Apple-spain/AppleII-VGA/AppleVGA/AppleVGA_BOM.xlsx

referencia | Descripcion | qty | P_Ali
PCB | Apple2vga | 1 | https://github.com/markadev/AppleII-VGA/
C1 – C58 | 0.1 uF, MLCC, 5 mm Pitch | 5 | https://es.aliexpress.com/item/1005001715033995.html?mp=1
C2 | Condensador 330nF THT radial 5.00mm entre pines | 1 | https://es.aliexpress.com/item/1005001715033995.html?mp=1
D1 | Diodo axial THT DO-41 schottky | 1 | https://es.aliexpress.com/item/1005004443278541.html?curPageLogUid=mMnkBYfFPmfH
J2 | Conector PinHeader 1x08 paso 2.54mm Vertical | 1 | https://es.aliexpress.com/item/4000857385112.html?pdp_pi=-1%252
J3 | Conector DSUB-15-HD VGA Female Horizontal (90º) | 1 | https://es.aliexpress.com/item/1005004701670869.html?curPageLogUid=ZuGPMabfmleB
R1-R3 | Resistencia 330R Axial THT 1/4W | 3 | https://es.aliexpress.com/item/4000695402017.html?spm=a2g0s.9042311.0.0.274263c0KP7QF1
R4, R7, R10 | Resistencia 500R Axial THT 1/4W (510R) | 3 | https://es.aliexpress.com/item/4000695402017.html?spm=a2g0s.9042311.0.0.274263c0KP7QF1
R5, R8, R11 | Resistencia 1K Axial THT 1/4W | 3 | https://es.aliexpress.com/item/4000695402017.html?spm=a2g0s.9042311.0.0.274263c0KP7QF1
R6, R9, R12 | Resistencia 2K Axial THT 1/4W | 3 | https://es.aliexpress.com/item/4000695402017.html?spm=a2g0s.9042311.0.0.274263c0KP7QF1
R13, R14 | Resistencia 47R Axial THT 1/4W | 2 | https://es.aliexpress.com/item/4000695402017.html?spm=a2g0s.9042311.0.0.274263c0KP7QF1
R15-R17 | Resistencia 10K Axial THT 1/4W | 3 | https://es.aliexpress.com/item/4000695402017.html?spm=a2g0s.9042311.0.0.274263c0KP7QF1
SW1 | Botón pulsador DPST (on)-off paso 6mm | 1 | https://es.aliexpress.com/item/4000695402017.html?spm=a2g0s.9042311.0.0.274263c0KP7QF1
U1-U3 | 74LVC245 DIP-20 | 3 | https://es.aliexpress.com/item/1005003499320188.html
U4 | 74LS07 DIP-14 | 1 | https://es.aliexpress.com/item/1005003087978058.html?mp=1
U5 | Regulador de voltaje 3.3v UA78M33CKCS TO-220-3 | 1 | https://es.aliexpress.com/item/32826540392.html
U6 | MCU RaspberryPi Pico | 1 | https://es.aliexpress.com/item/1005005658292169.html?scm_id=1007.13339.291025.0&scm-url=1007.13339.291025.0
Z1-Z3 | zocalos 20DIP300 | 3 | https://es.aliexpress.com/item/4001048163251.html?spm=a2g0o.cart.0.0.5b263c00thiOeW&mp=1
Z4 | zocalos 14DIP300 | 1 | https://es.aliexpress.com/item/4001048163251.html?spm=a2g0o.cart.0.0.5b263c00thiOeW&mp=1
no_ref | adaptador vga | 1 | https://es.aliexpress.com/item/1005004328077008.html
