Apple-spain/AppleII-VGA/AppleVGA/AppleVGA.kicad_pcb

## KiCad design AppleVGA/AppleVGA.kicad_pcb (2023-11-20)

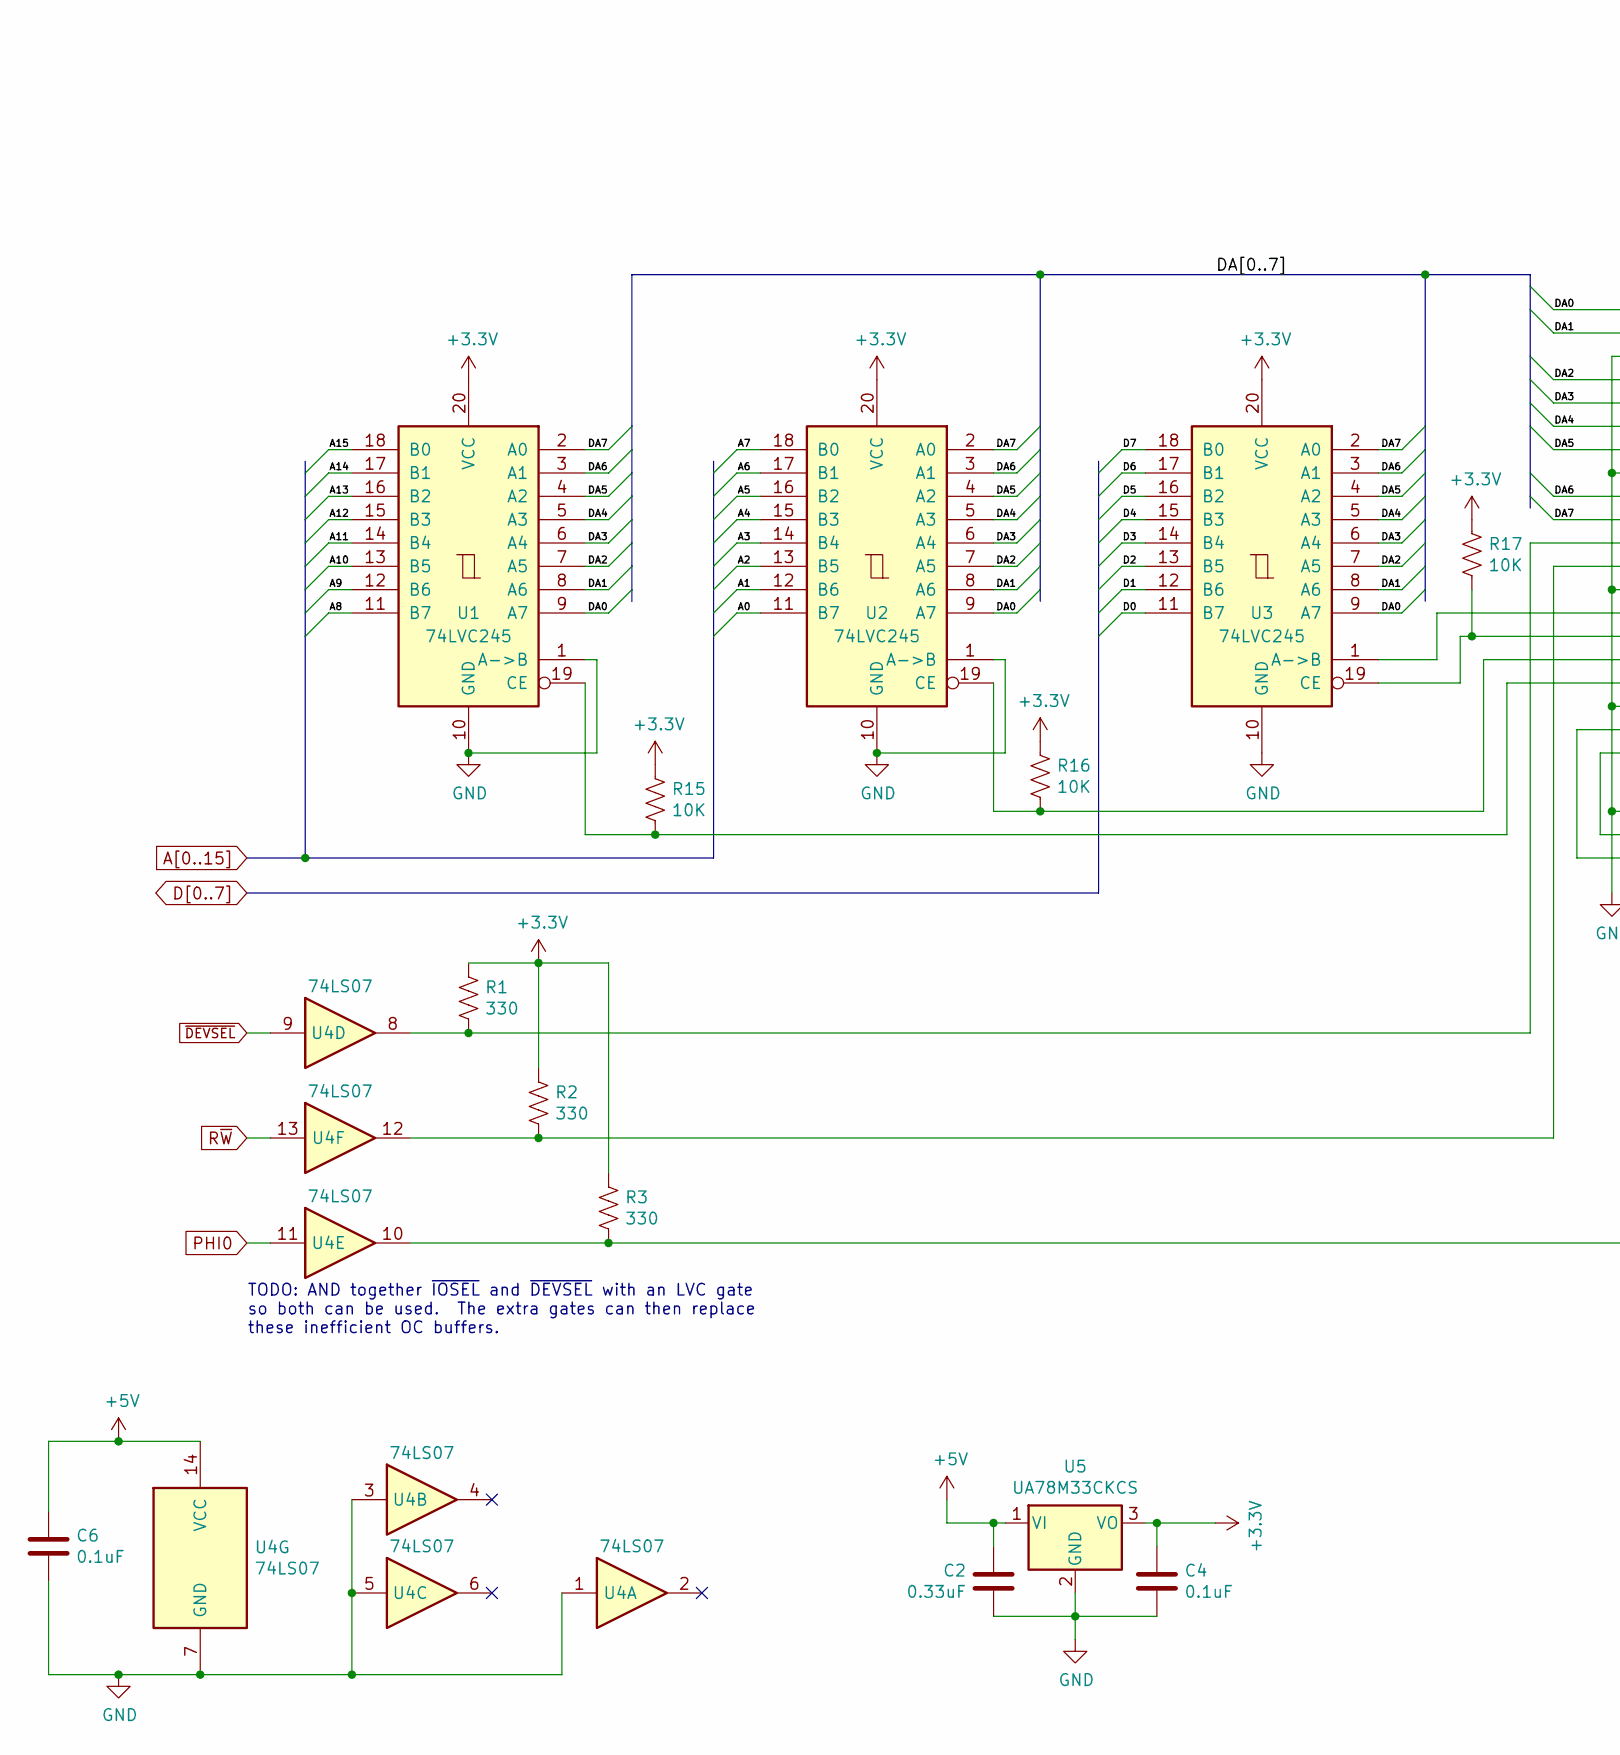
[picture p1: schematic AppleVGA.kicad_sch, Apple II VGA Card, part in row 1, column 1]

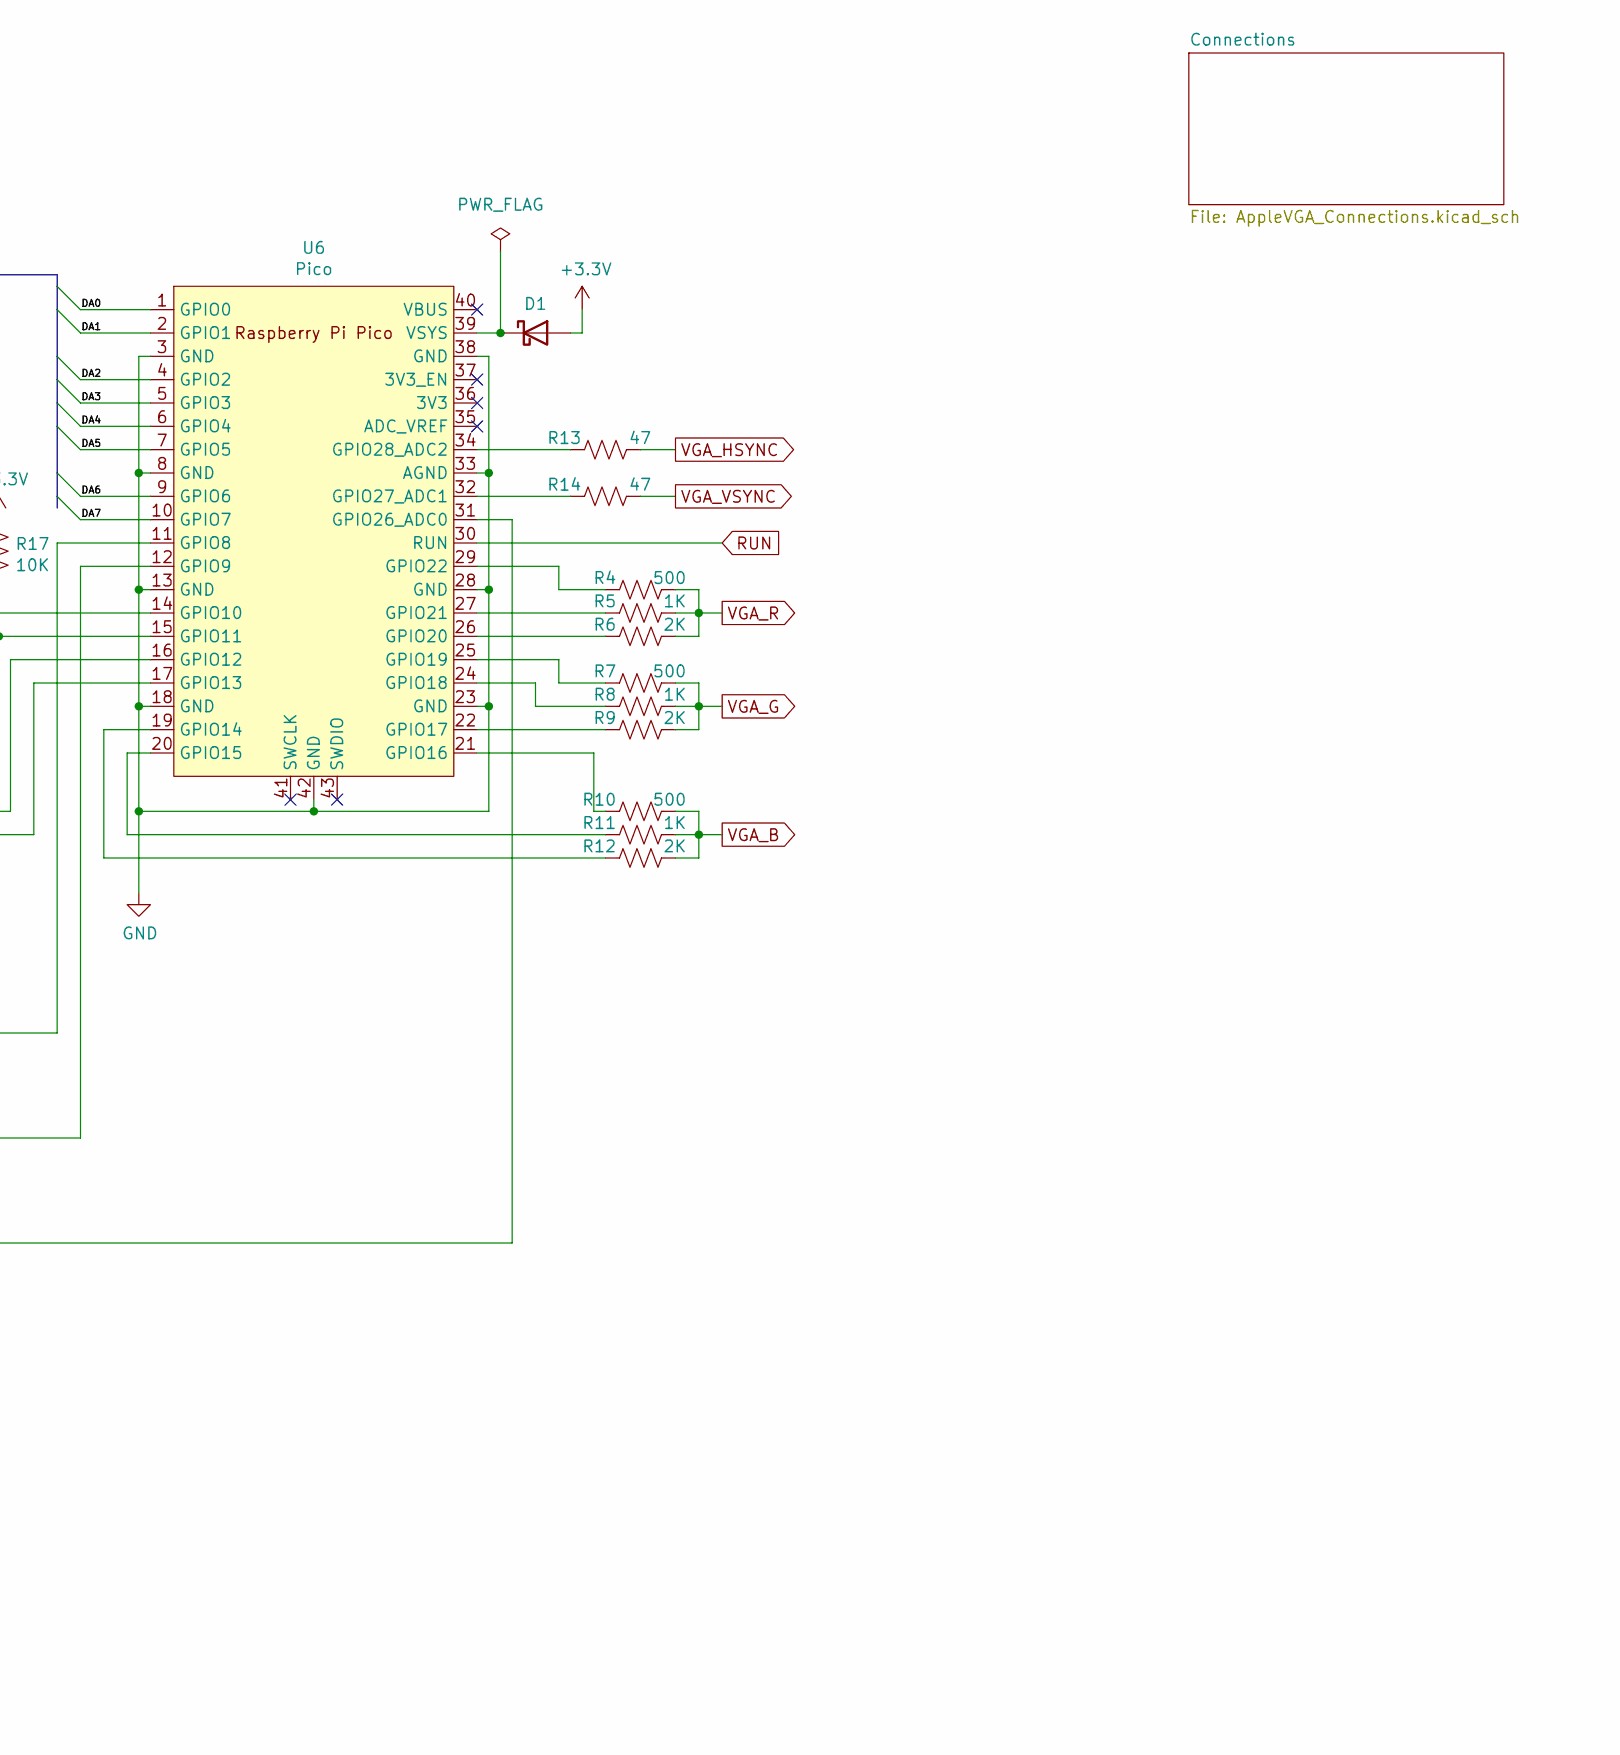
[picture p2: schematic AppleVGA.kicad_sch, Apple II VGA Card, part in row 1, column 2]

Parts:
C2: 0.33uF; C_Disc_D4.3mm_W1.9mm_P5.00mm
C4, C6: 0.1uF; C_Disc_D4.3mm_W1.9mm_P5.00mm
D1: D_Schottky; D_DO-41_SOD81_P10.16mm_Horizontal
R1, R2, R3: 330; R_Axial_DIN0207_L6.3mm_D2.5mm_P10.16mm_Horizontal
R4, R7, R10: 500; R_Axial_DIN0207_L6.3mm_D2.5mm_P10.16mm_Horizontal
R5, R8, R11: 1K; R_Axial_DIN0207_L6.3mm_D2.5mm_P10.16mm_Horizontal
R6, R9, R12: 2K; R_Axial_DIN0207_L6.3mm_D2.5mm_P10.16mm_Horizontal
R13, R14: 47; R_Axial_DIN0207_L6.3mm_D2.5mm_P10.16mm_Horizontal
R15, R16, R17: 10K; R_Axial_DIN0207_L6.3mm_D2.5mm_P10.16mm_Horizontal
U1, U2, U3: 74LVC245; DIP-20_W7.62mm_Socket
U4: 74LS07; DIP-14_W7.62mm_Socket
U5: UA78M33CKCS; TO-220-3_Horizontal_TabDown
U6: Pico; RPi_Pico_SMD_TH

Connections:
+3.3V: C4.1, D1.2 (A), R1.1, R2.1, R3.1, R15.1, R16.1, R17.1, U1.20 (VCC), U2.20 (VCC), U3.20 (VCC), U5.3 (VO); also elsewhere on the board
+5V: C2.2, C6.1, U4.14 (VCC), U5.1 (VI); also elsewhere on the board
/DA0: U1.9 (A7), U2.9 (A7), U3.9 (A7), U6.1 (GPIO0)
/DA1: U1.8 (A6), U2.8 (A6), U3.8 (A6), U6.2 (GPIO1)
/DA2: U1.7 (A5), U2.7 (A5), U3.7 (A5), U6.4 (GPIO2)
/DA3: U1.6 (A4), U2.6 (A4), U3.6 (A4), U6.5 (GPIO3)
/DA4: U1.5 (A3), U2.5 (A3), U3.5 (A3), U6.6 (GPIO4)
/DA5: U1.4 (A2), U2.4 (A2), U3.4 (A2), U6.7 (GPIO5)
/DA6: U1.3 (A1), U2.3 (A1), U3.3 (A1), U6.9 (GPIO6)
/DA7: U1.2 (A0), U2.2 (A0), U3.2 (A0), U6.10 (GPIO7)
A0: U2.11 (B7); also elsewhere on the board
A1: U2.12 (B6); also elsewhere on the board
A2: U2.13 (B5); also elsewhere on the board
A3: U2.14 (B4); also elsewhere on the board
A4: U2.15 (B3); also elsewhere on the board
A5: U2.16 (B2); also elsewhere on the board
A6: U2.17 (B1); also elsewhere on the board
A7: U2.18 (B0); also elsewhere on the board
A8: U1.11 (B7); also elsewhere on the board
A9: U1.12 (B6); also elsewhere on the board
A10: U1.13 (B5); also elsewhere on the board
A11: U1.14 (B4); also elsewhere on the board
A12: U1.15 (B3); also elsewhere on the board
A13: U1.16 (B2); also elsewhere on the board
A14: U1.17 (B1); also elsewhere on the board
A15: U1.18 (B0); also elsewhere on the board
D0: U3.11 (B7); also elsewhere on the board
D1: U3.12 (B6); also elsewhere on the board
D2: U3.13 (B5); also elsewhere on the board
D3: U3.14 (B4); also elsewhere on the board
D4: U3.15 (B3); also elsewhere on the board
D5: U3.16 (B2); also elsewhere on the board
D6: U3.17 (B1); also elsewhere on the board
D7: U3.18 (B0); also elsewhere on the board
GND: C2.1, C4.2, C6.2, U1.1 (A->B), U1.10 (GND), U2.1 (A->B), U2.10 (GND), U3.10 (GND), U4.1, U4.3, U4.5, U4.7 (GND), U5.2 (GND), U6.3 (GND), U6.8 (GND), U6.13 (GND), U6.18 (GND), U6.23 (GND), U6.28 (GND), U6.33 (AGND), U6.38 (GND), U6.42 (GND); also elsewhere on the board
unnamed: D1.1 (K), U6.39 (VSYS)
unnamed: R15.2, U1.19 (CE), U6.17 (GPIO13)
unnamed: R16.2, U2.19 (CE), U6.16 (GPIO12)
unnamed: U3.1 (A->B), U6.14 (GPIO10)
unnamed: R17.2, U3.19 (CE), U6.15 (GPIO11)
unnamed: R1.2, U4.8, U6.11 (GPIO8)
unnamed: R2.2, U4.12, U6.12 (GPIO9)
unnamed: R12.1, U6.19 (GPIO14)
unnamed: R11.1, U6.20 (GPIO15)
unnamed: R10.1, U6.21 (GPIO16)
unnamed: R9.1, U6.22 (GPIO17)
unnamed: R8.1, U6.24 (GPIO18)
unnamed: R7.1, U6.25 (GPIO19)
unnamed: R6.1, U6.26 (GPIO20)
unnamed: R5.1, U6.27 (GPIO21)
unnamed: R4.1, U6.29 (GPIO22)
unnamed: R3.2, U4.10, U6.31 (GPIO26_ADC0)
unnamed: R14.1, U6.32 (GPIO27_ADC1)
unnamed: R13.1, U6.34 (GPIO28_ADC2)
PHI0: U4.11; also elsewhere on the board
RUN: U6.30 (RUN); also elsewhere on the board
R~W: U4.13; also elsewhere on the board
VGA_B: R10.2, R11.2, R12.2; also elsewhere on the board
VGA_G: R7.2, R8.2, R9.2; also elsewhere on the board
VGA_HSYNC: R13.2; also elsewhere on the board
VGA_R: R4.2, R5.2, R6.2; also elsewhere on the board
VGA_VSYNC: R14.2; also elsewhere on the board
~DEVSEL: U4.9; also elsewhere on the board

Notes on the sheet:
TODO: AND together ~{IOSEL} and ~{DEVSEL} with an LVC gate so both can be used. The extra gates can then replace these inefficient OC buffers.

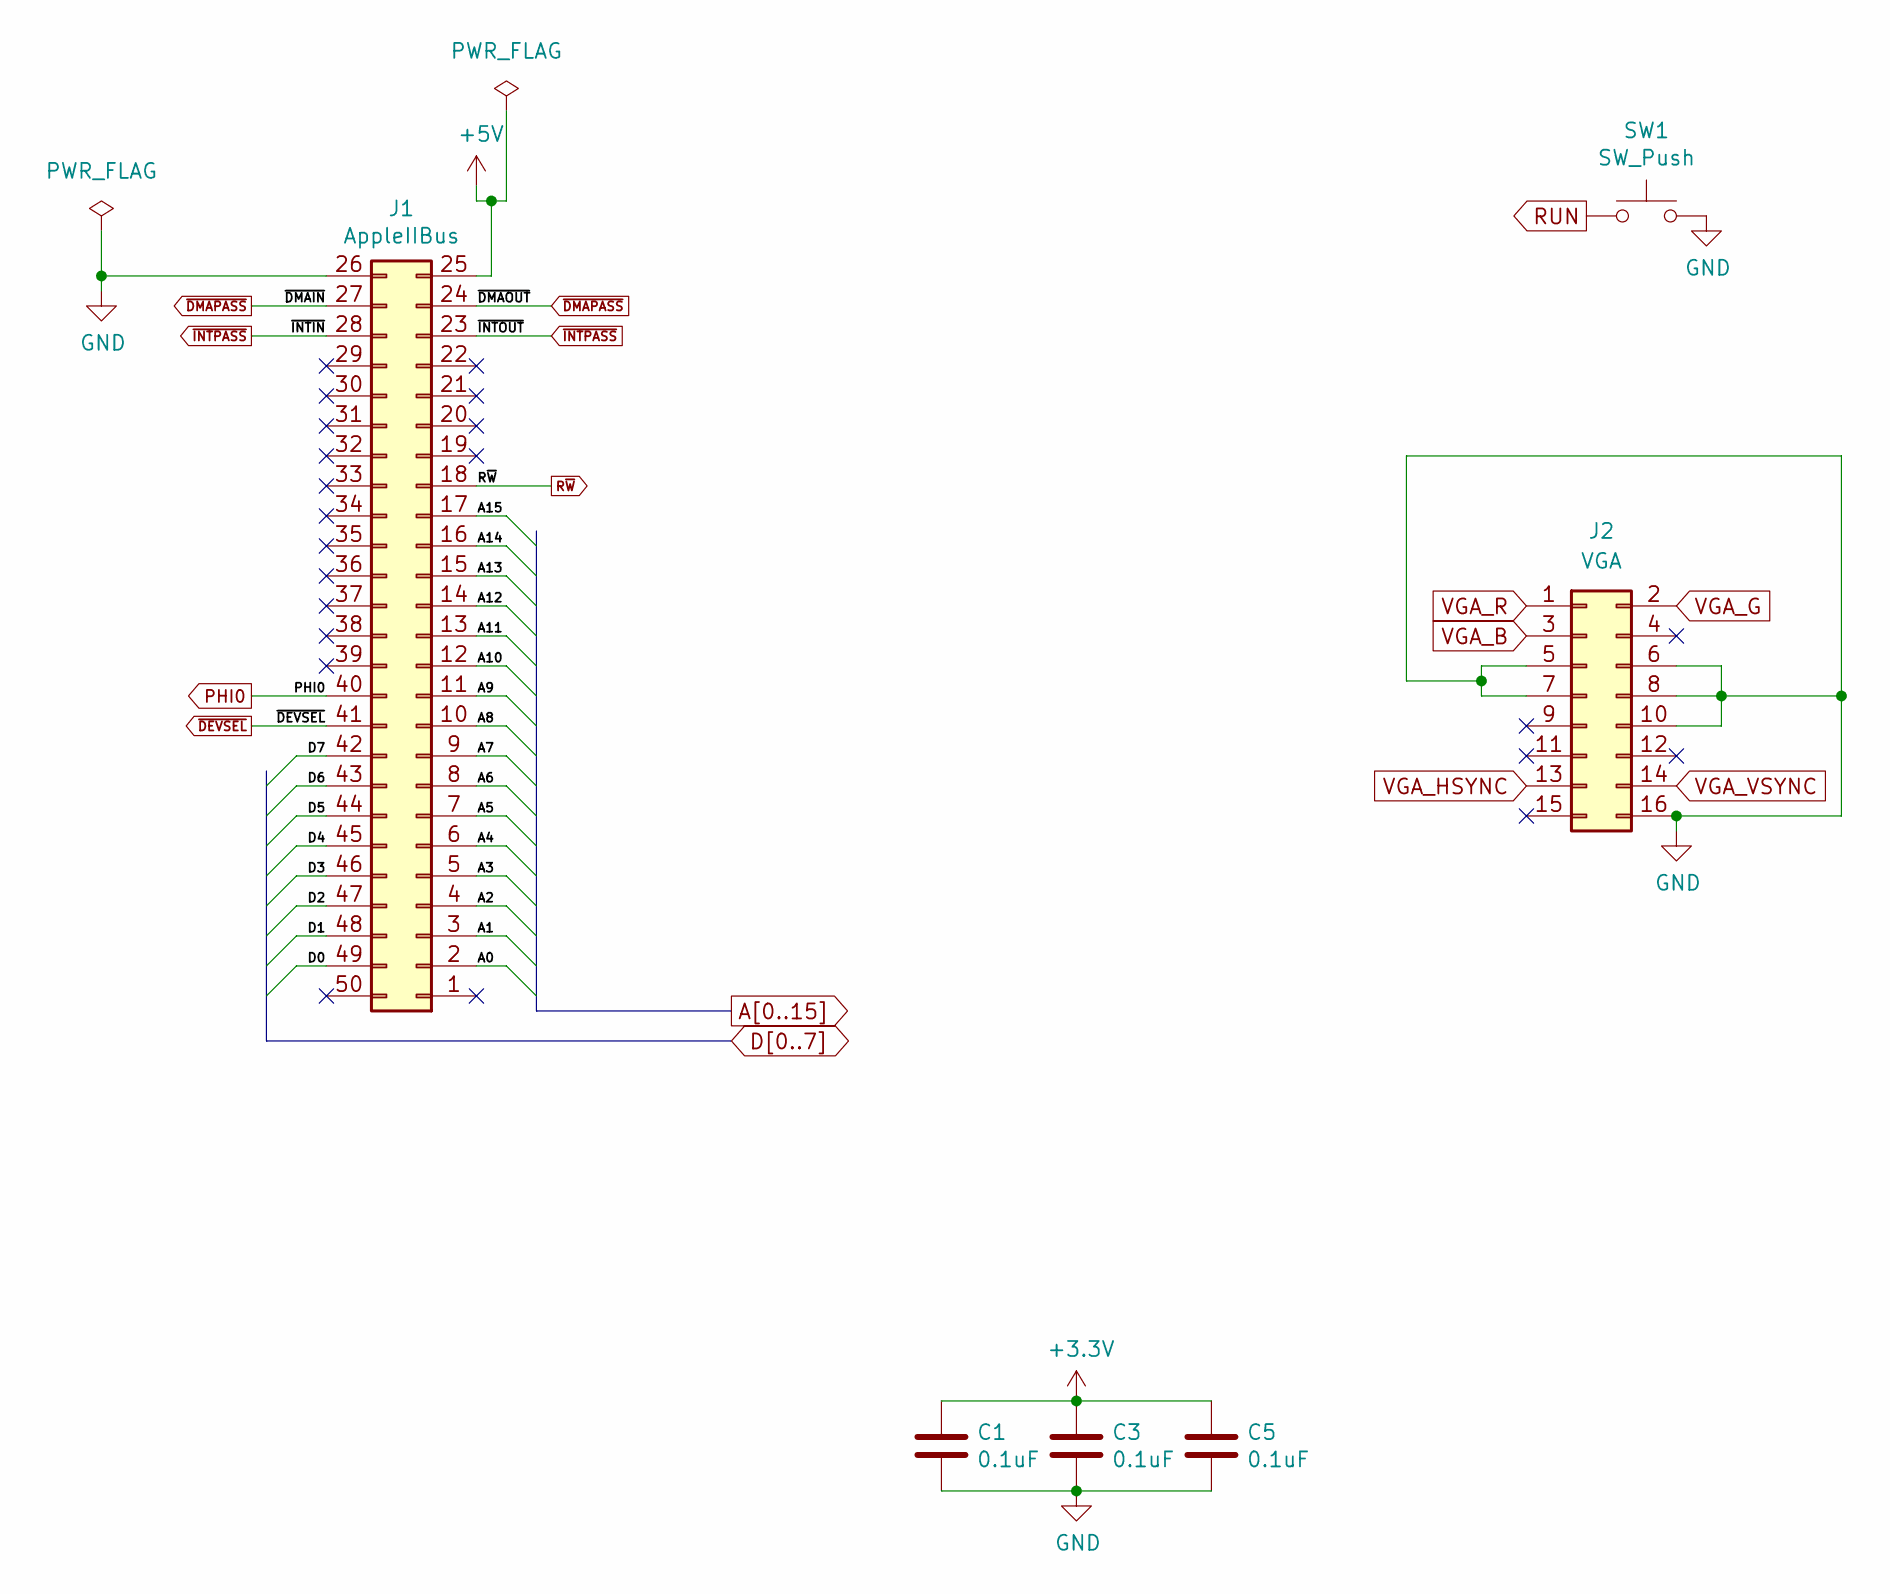
[picture p3: schematic AppleVGA_Connections.kicad_sch, Apple II VGA Card]

Parts:
C1, C3, C5: 0.1uF; C_Disc_D4.3mm_W1.9mm_P5.00mm
J1: AppleIIBus; AppleIIBus_Edge
J2: VGA; PinSocket_2x08_P2.54mm_Vertical
SW1: SW_Push; SW_PUSH_6mm_H5mm

Connections:
+3.3V: C1.1, C3.1, C5.1; also elsewhere on the board
+5V: J1.25; also elsewhere on the board
A0: J1.2; also elsewhere on the board
A1: J1.3; also elsewhere on the board
A2: J1.4; also elsewhere on the board
A3: J1.5; also elsewhere on the board
A4: J1.6; also elsewhere on the board
A5: J1.7; also elsewhere on the board
A6: J1.8; also elsewhere on the board
A7: J1.9; also elsewhere on the board
A8: J1.10; also elsewhere on the board
A9: J1.11; also elsewhere on the board
A10: J1.12; also elsewhere on the board
A11: J1.13; also elsewhere on the board
A12: J1.14; also elsewhere on the board
A13: J1.15; also elsewhere on the board
A14: J1.16; also elsewhere on the board
A15: J1.17; also elsewhere on the board
D0: J1.49; also elsewhere on the board
D1: J1.48; also elsewhere on the board
D2: J1.47; also elsewhere on the board
D3: J1.46; also elsewhere on the board
D4: J1.45; also elsewhere on the board
D5: J1.44; also elsewhere on the board
D6: J1.43; also elsewhere on the board
D7: J1.42; also elsewhere on the board
GND: C1.2, C3.2, C5.2, J1.26, J2.5, J2.6, J2.7, J2.8, J2.10, J2.16, SW1.2; also elsewhere on the board
PHI0: J1.40; also elsewhere on the board
RUN: SW1.1; also elsewhere on the board
R~W: J1.18; also elsewhere on the board
VGA_B: J2.3; also elsewhere on the board
VGA_G: J2.2; also elsewhere on the board
VGA_HSYNC: J2.13; also elsewhere on the board
VGA_R: J2.1; also elsewhere on the board
VGA_VSYNC: J2.14; also elsewhere on the board
~DEVSEL: J1.41; also elsewhere on the board
~DMAPASS: J1.24, J1.27
~INTPASS: J1.23, J1.28

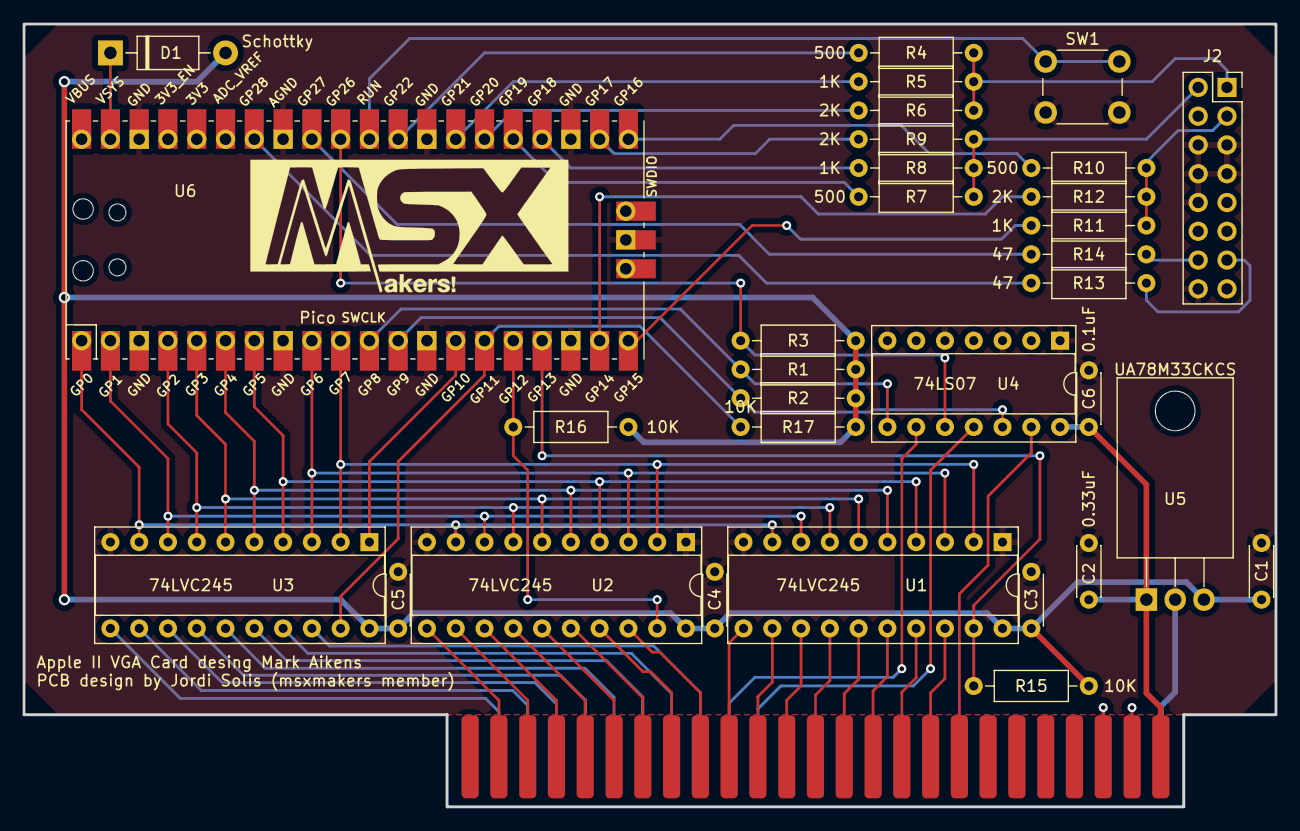
[picture p4: board AppleVGA.kicad_pcb from above]

Board: 2 copper layers, 110.5 x 69.1 mm, 33 parts (0 on the bottom side), 65 nets.
