Apple-spain/AppleII-VGA/(notices)

Notices in the files:
AppleVGA/AppleVGA_Connections.kicad_sch:
Licensed under CERN-OHL-P V2.0 (https://ohwr.org/cern_ohl_p_v2.txt)
Copyright (c) 2021-2022 Mark Aikens
